HaptiCare/HaptiCare-KiCad/ESPModul_schematic.pptx

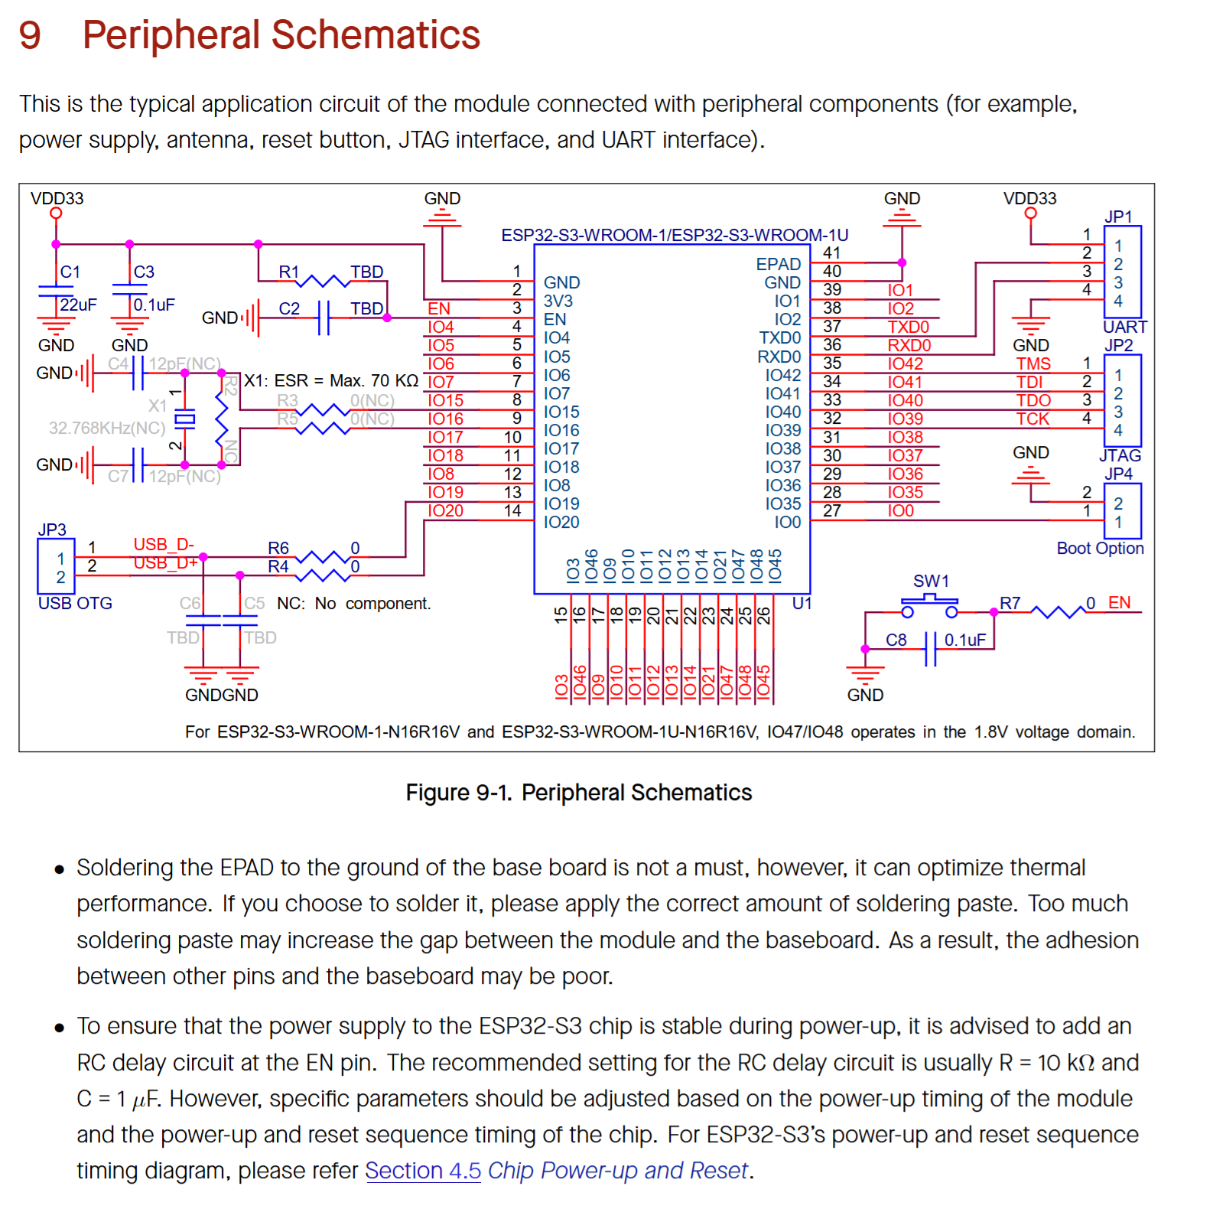
[picture p1: figure]

Additional programming interface

USB for programming

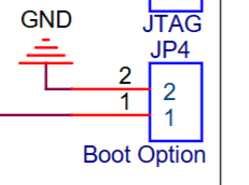
[picture p2: figure]

Reset Option

Include this circuit to reset the microcontroller via button
