HaptiCare/HaptiCare-KiCad/HaptiCare design.kicad_pcb

## KiCad design HaptiCare design.kicad_pcb (2026-11-10)

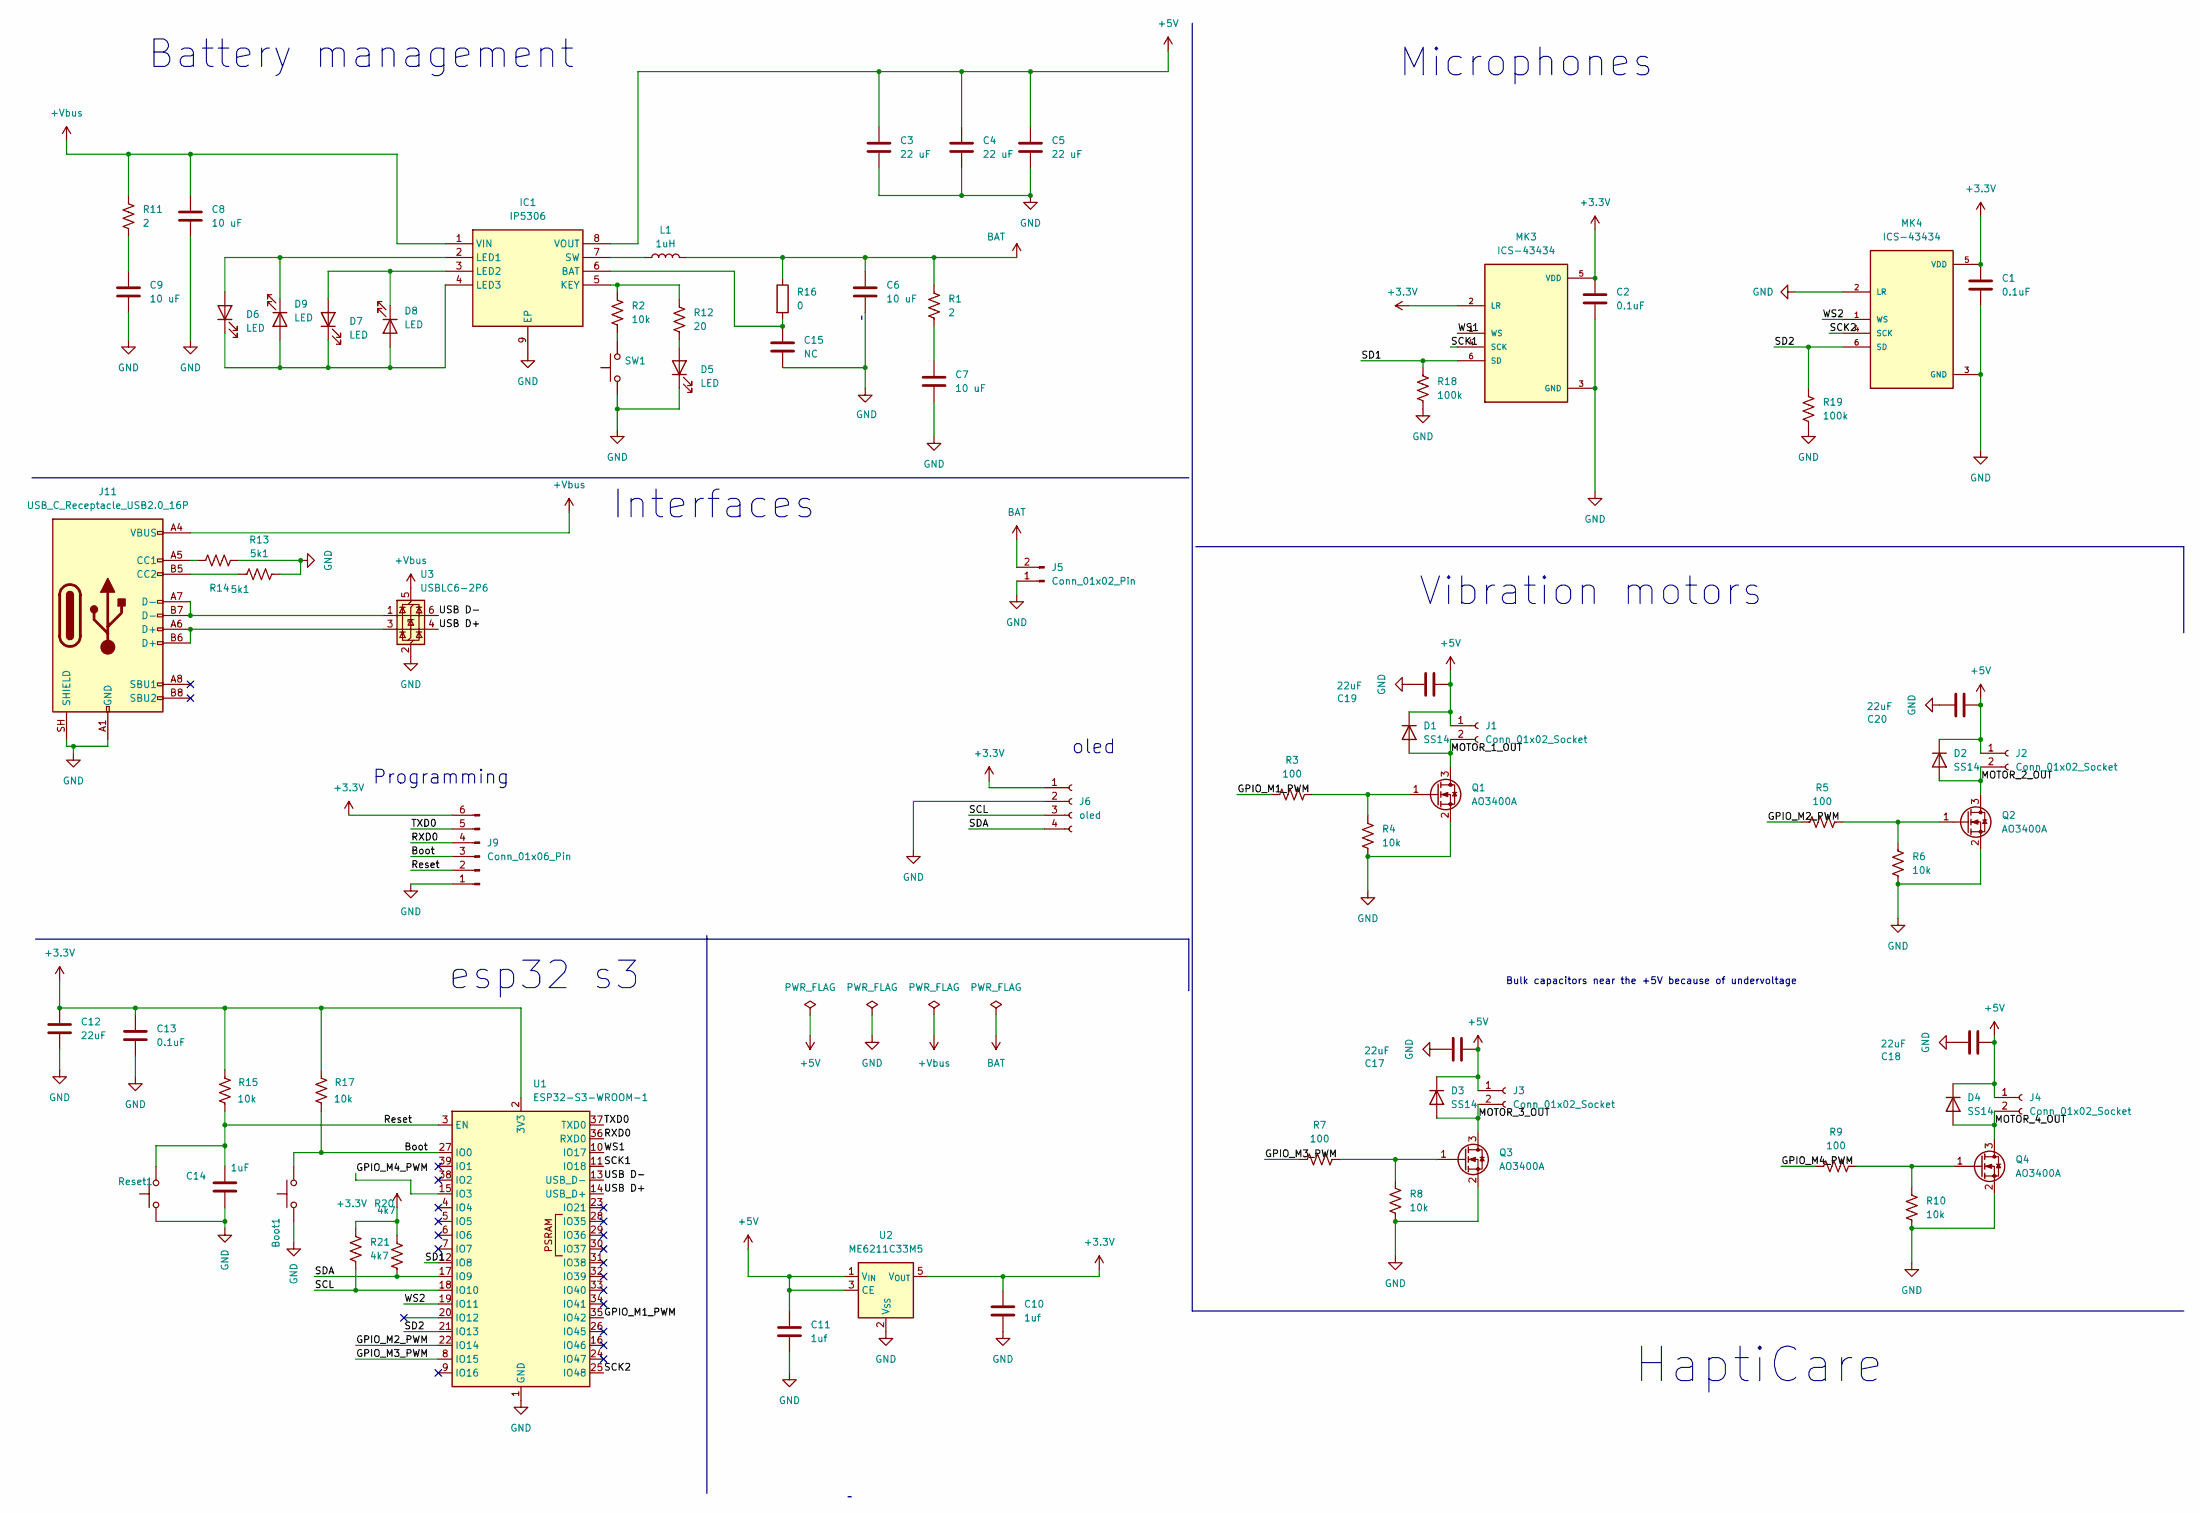
[picture p3: schematic HaptiCare design.kicad_sch]

Parts:
Boot1: SW_Push; SW_SPST_Omron_B3FS-100xP
C1, C2, C13: 0.1uF; C_0805_2012Metric
C3, C4, C5: 22 uF; C_0805_2012Metric
C6, C7, C8, C9: 10 uF; C_0805_2012Metric
C10, C11: 1uf; C_0805_2012Metric
C12, C17, C18, C19, C20: 22uF; C_0805_2012Metric
C14: 1uF; C_0805_2012Metric
C15: NC; C_0805_2012Metric
D1, D2, D3, D4: SS14; D_SMA
D5, D6, D7, D8, D9: LED; LED_0805_2012Metric
IC1: IP5306; SOIC127P600X165-9N; Manufacturer_Part_Number IP5306
J1, J2, J3, J4: Conn_01x02_Socket; JST_PH_B2B-PH-K_1x02_P2.00mm_Vertical
J5: Conn_01x02_Pin; PinSocket_1x02_P2.54mm_Vertical
J6: oled; PinSocket_1x04_P2.54mm_Vertical
J9: Conn_01x06_Pin; PinSocket_1x06_P2.54mm_Vertical
J11: USB_C_Receptacle_USB2.0_16P; USB_C_Receptacle_GCT_USB4105-xx-A_16P_TopMnt_Horizontal
L1: 1uH; L_Coilcraft_XxL4020
MK3, MK4: ICS-43434; MIC_ICS-43434
Q1, Q2, Q3, Q4: AO3400A; SOT-23
R1, R11: 2; R_0805_2012Metric
R2, R4, R6, R8, R10, R15, R17: 10k; R_0805_2012Metric
R3, R5, R7, R9: 100; R_0805_2012Metric
R12: 20; R_0805_2012Metric
R13, R14: 5k1; R_0805_2012Metric
R16: 0; R_0805_2012Metric
R18, R19: 100k; R_0805_2012Metric
R20, R21: 4k7; R_0805_2012Metric
Reset1: SW_Push; SW_SPST_Omron_B3FS-100xP
SW1: SW_Push; SW_SPST_Omron_B3FS-100xP
U1: ESP32-S3-WROOM-1
U2: ME6211C33M5; SOT-23-5
U3: USBLC6-2P6; SOT-666

Connections:
+3.3V: C1.1, C2.1, C10.1, C12.1, C13.1, J6.1, J9.6, MK3.2 (LR), MK3.5 (VDD), MK4.5 (VDD), R15.2, R17.2, R20.2, R21.2, U1.2 (3V3), U2.5 (V_{OUT})
+5V: C3.1, C4.1, C5.1, C11.1, C17.1, C18.1, C19.1, C20.1, D1.1 (K), D2.1 (K), D3.1 (K), D4.1 (K), IC1.8 (VOUT), J1.1, J2.1, J3.1, J4.1, U2.1 (V_{IN}), U2.3 (CE)
+Vbus: C8.1, IC1.1 (VIN), J11.A4 (VBUS), J11.A9 (VBUS), J11.B4 (VBUS), J11.B9 (VBUS), R11.1, U3.5 (VBUS)
/Boot: Boot1.2, J9.3, R17.1, U1.27 (IO0)
/GPIO_M1_PWM: R3.1, U1.35 (IO42)
/GPIO_M2_PWM: R5.1, U1.22 (IO14)
/GPIO_M3_PWM: R7.1, U1.8 (IO15)
/GPIO_M4_PWM: R9.1, U1.15 (IO3)
/MOTOR_1_OUT: D1.2 (A), J1.2, Q1.3 (D)
/MOTOR_2_OUT: D2.2 (A), J2.2, Q2.3 (D)
/MOTOR_3_OUT: D3.2 (A), J3.2, Q3.3 (D)
/MOTOR_4_OUT: D4.2 (A), J4.2, Q4.3 (D)
/RXD0: J9.4, U1.36 (RXD0)
/Reset: C14.2, J9.2, R15.1, Reset1.2, U1.3 (EN)
/SCK1: MK3.4 (SCK), U1.11 (IO18)
/SCK2: MK4.4 (SCK), U1.25 (IO48)
/SCL: J6.3, R21.1, U1.18 (IO10)
/SD1: MK3.6 (SD), R18.1, U1.12 (IO8)
/SD2: MK4.6 (SD), R19.1, U1.21 (IO13)
/SDA: J6.4, R20.1, U1.17 (IO9)
/TXD0: J9.5, U1.37 (TXD0)
/USB D+: U1.14 (USB_D+), U3.4 (I/O2)
/USB D-: U1.13 (USB_D-), U3.6 (I/O1)
/WS1: MK3.1 (WS), U1.10 (IO17)
/WS2: MK4.1 (WS), U1.19 (IO11)
BAT: C6.1, J5.2, L1.2, R1.1, R16.1
GND: Boot1.1, C1.2, C2.2, C3.2, C4.2, C5.2, C6.2, C7.2, C8.2, C9.2, C10.2, C11.2, C12.2, C13.2, C14.1, C15.2, C17.2, C18.2, C19.2, C20.2, D5.1 (K), IC1.9 (EP), J5.1, J6.2, J9.1, J11.A1 (GND), J11.A12 (GND), J11.B1 (GND), J11.B12 (GND), J11.SH (SHIELD), MK3.3 (GND), MK4.2 (LR), MK4.3 (GND), Q1.2 (S), Q2.2 (S), Q3.2 (S), Q4.2 (S), R4.2, R6.2, R8.2, R10.2, R13.2, R14.2, R18.2, R19.2, Reset1.1, SW1.1, U1.1 (GND), U1.40 (GND), U1.41 (GND), U2.2 (V_{SS}), U3.2 (GND)
unnamed: C7.1, R1.2
unnamed: C9.1, R11.2
unnamed: D5.2 (A), R12.2
unnamed: D6.2 (A), D9.1 (K), IC1.2 (LED1)
unnamed: D6.1 (K), D7.1 (K), D8.2 (A), D9.2 (A), IC1.4 (LED3)
unnamed: D7.2 (A), D8.1 (K), IC1.3 (LED2)
unnamed: C15.1, IC1.6 (BAT), R16.2
unnamed: IC1.5 (KEY), R2.1, R12.1
unnamed: IC1.7 (SW), L1.1
unnamed: J11.A5 (CC1), R14.1
unnamed: J11.B5 (CC2), R13.1
unnamed: J11.A6 (D+), J11.B6 (D+), U3.3 (I/O2)
unnamed: J11.A7 (D-), J11.B7 (D-), U3.1 (I/O1)
unnamed: Q1.1 (G), R3.2, R4.1
unnamed: Q2.1 (G), R5.2, R6.1
unnamed: Q3.1 (G), R7.2, R8.1
unnamed: Q4.1 (G), R9.2, R10.1
unnamed: R2.2, SW1.2

Notes on the sheet:
Battery management
esp32 s3
Vibration motors
oled
HaptiCare
Microphones
Programming
Interfaces
Bulk capacitors near the +5V because of undervoltage

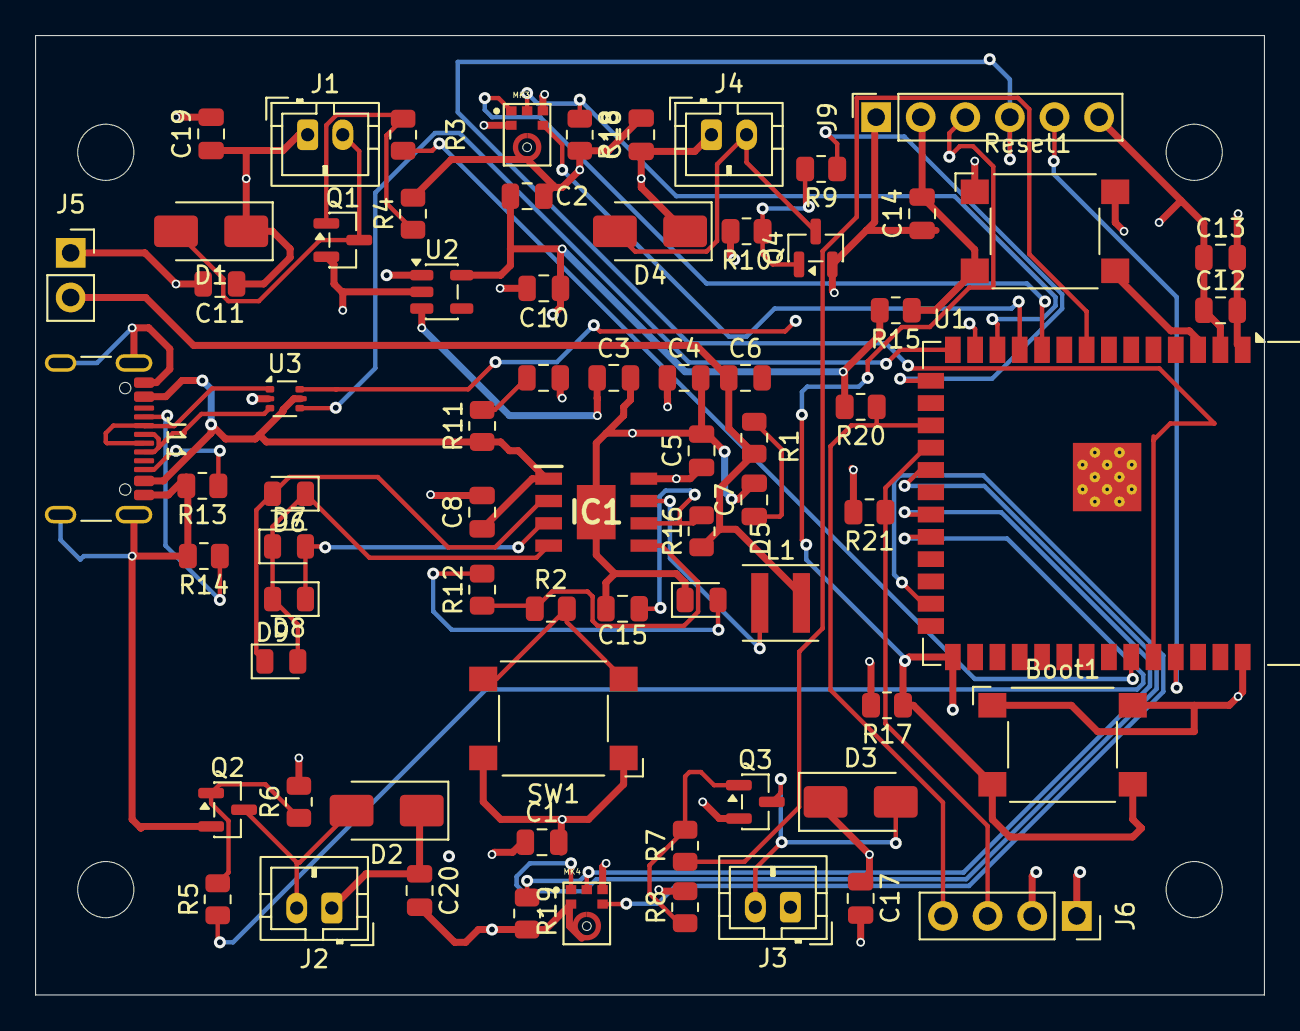
[picture p4: board HaptiCare design.kicad_pcb from above]

Board: 4 copper layers, 70.0 x 54.7 mm, 71 parts (0 on the bottom side), 45 nets.
