HaptiCare/HaptiCare-KiCad/(commit log)

2026-08-26 Add initial HaptiCare KiCad design
    [HaptiCare design.kicad_pcb, HaptiCare design.kicad_sch]
2026-09-01 Add datasheet and esp schematic
2026-09-14 Update power management, ESP32 programming, and sub-schematics
    [ESP32.kicad_sch, HaptiCare design.kicad_sch, Microphone.kicad_sch, Motors.kicad_sch, OLED.kicad_sch, power.kicad_sch]
2026-09-17 Add ESD protection and change net names
    [HaptiCare design.kicad_sch]
2026-10-01 Update schematic, add .gitignore
2026-11-05 PCB: board outline, mounting holes, placement of connectors, ESP32, motors, mics
2026-11-10 PCB: 4-layer stackup, zones, power and USB routing, DRC fixes
2026-11-10 Add LCSC part numbers, swap L1 to in-stock XFL4020, JST battery connector, IP5306 keep-alive and battery sense; add REVIEW.md
